muhammadahmedajaz/fobo-surface-robot/assets/build/pool-overview.jpg

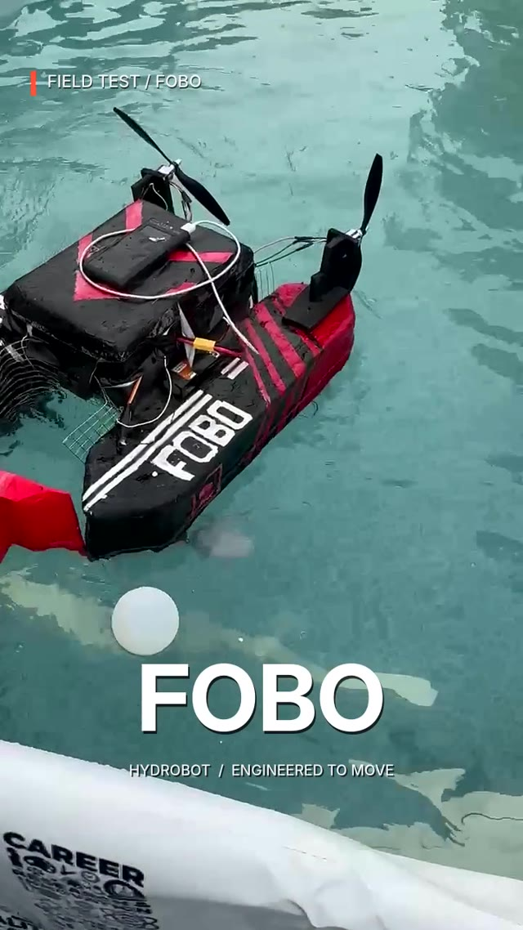
assets/build/pool-overview.jpg
