muhammadahmedajaz/fobo-surface-robot/assets/figures/control_architecture.png

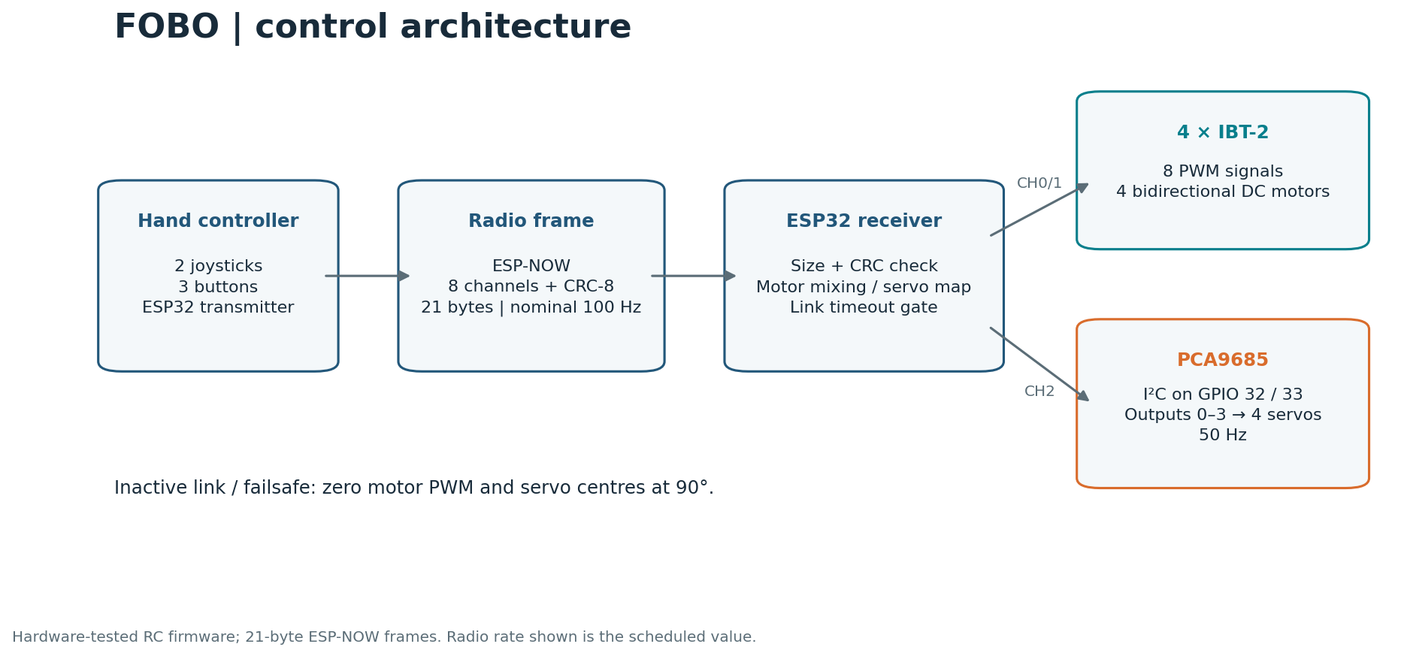
assets/figures/control_architecture.png
