muhammadahmedajaz/fobo-surface-robot/assets/figures/disturbance_rejection.png

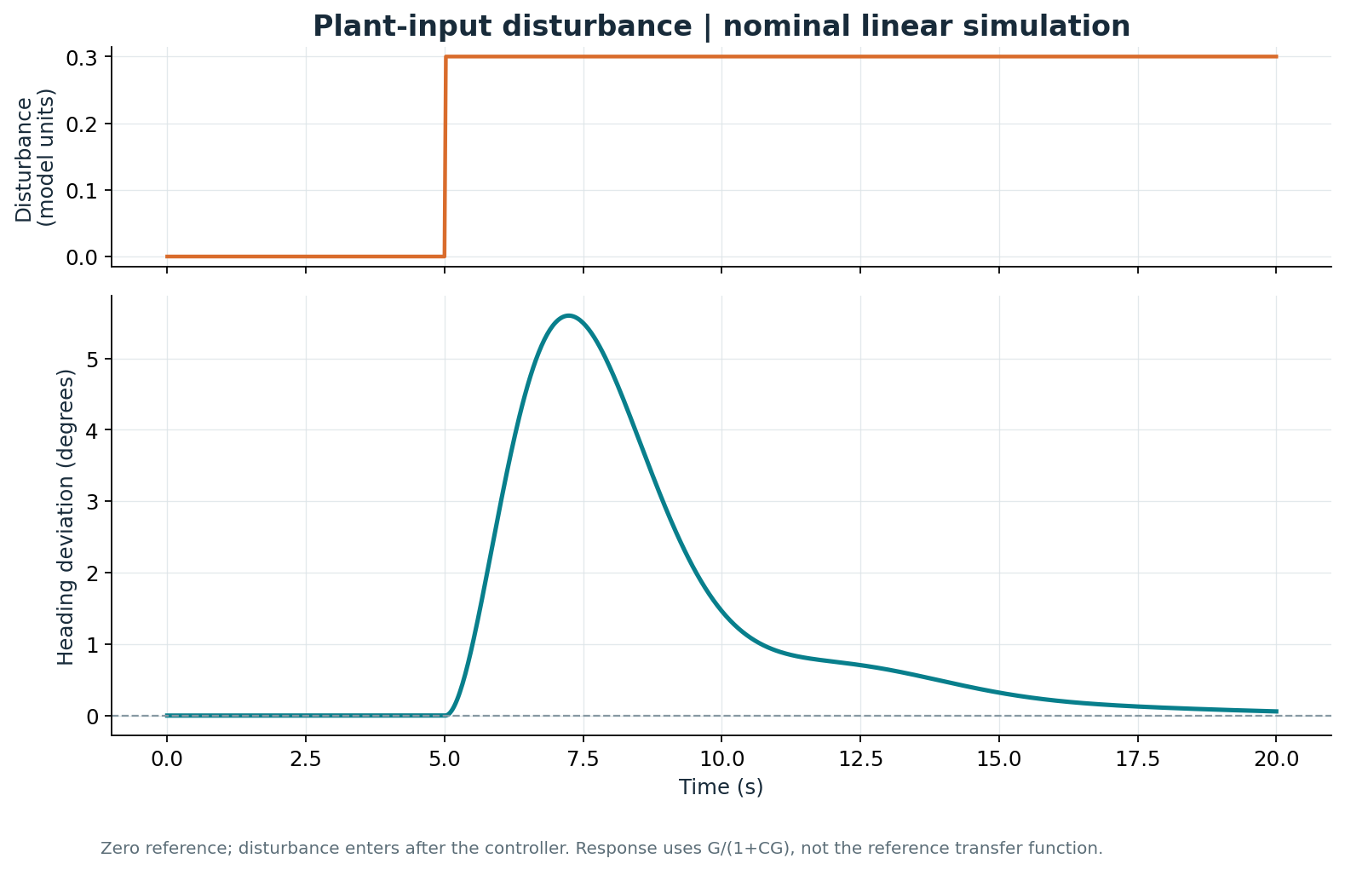
assets/figures/disturbance_rejection.png
