muhammadahmedajaz/fobo-surface-robot/assets/figures/motor_command_map.png

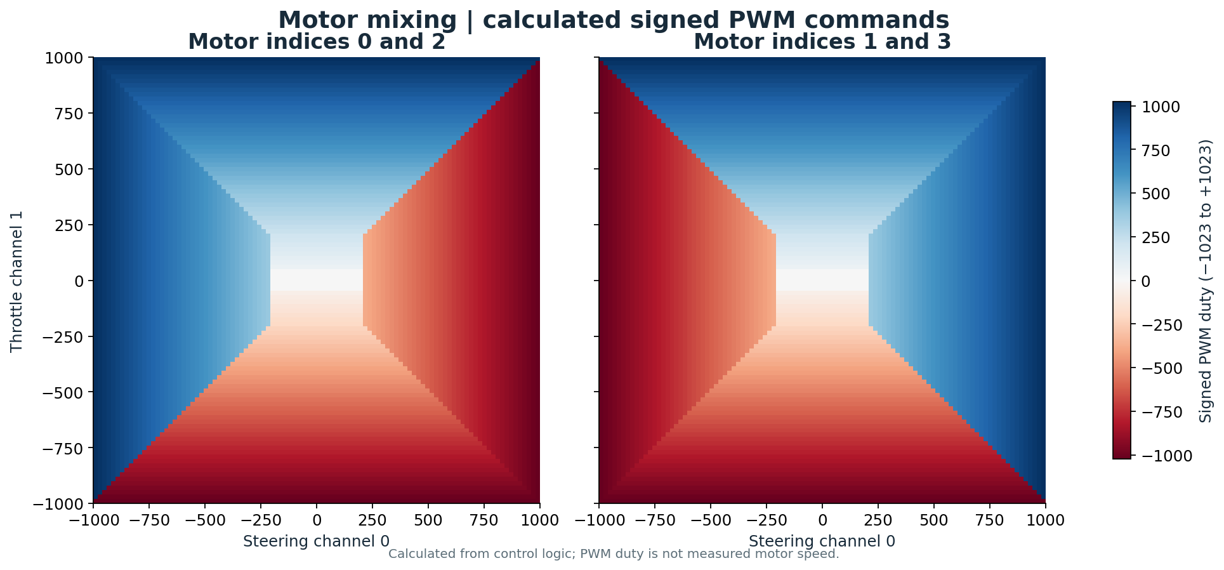
assets/figures/motor_command_map.png
