muhammadahmedajaz/fobo-surface-robot/assets/figures/servo_command_map.png

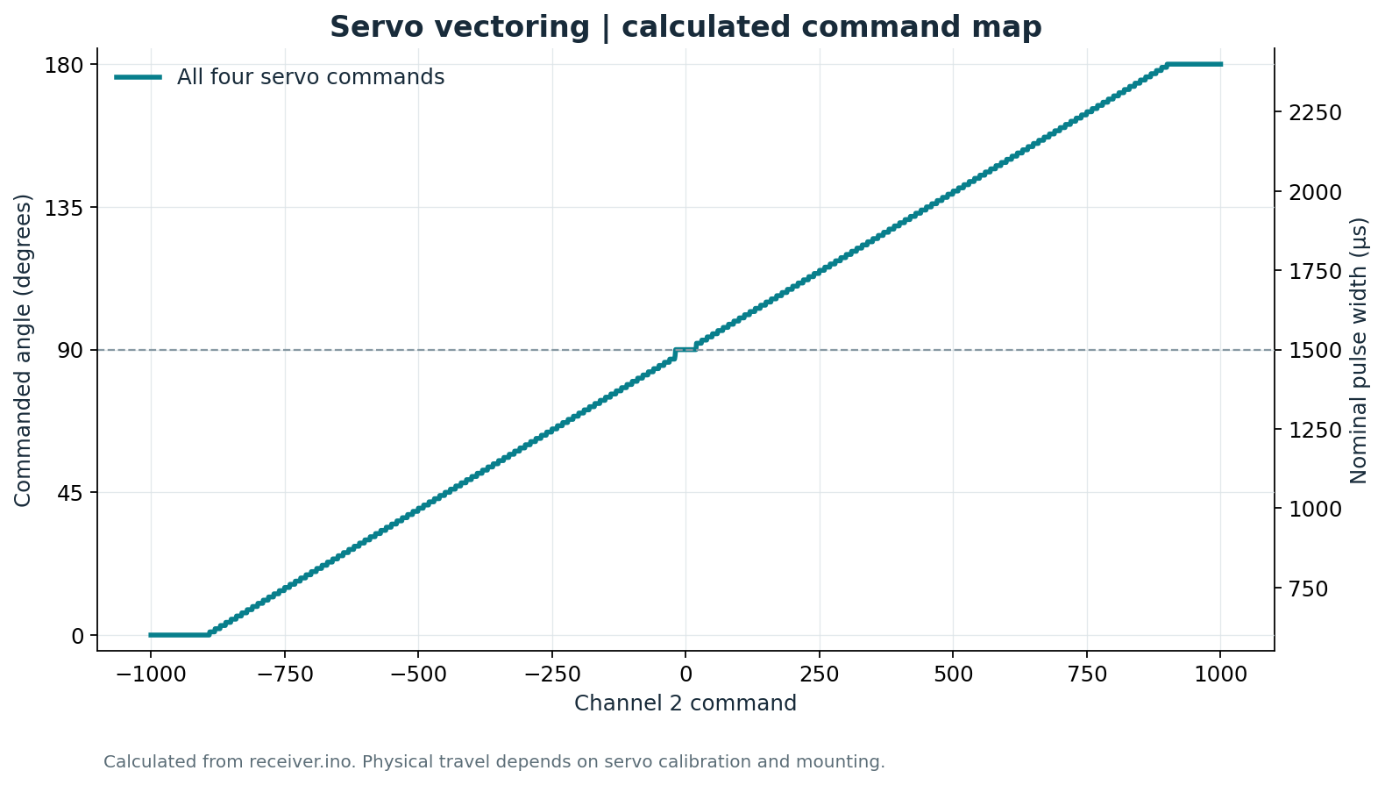
assets/figures/servo_command_map.png
