muhammadahmedajaz/fobo-surface-robot/assets/fobo-on-water.png

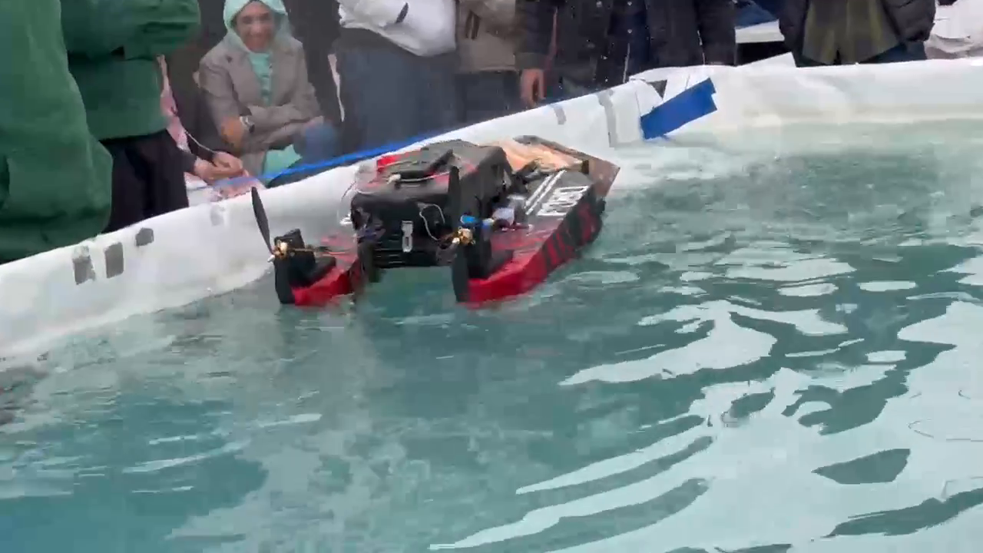
assets/fobo-on-water.png
