muhammadahmedajaz/fobo-surface-robot/assets/build/development/foam-shaping.jpg

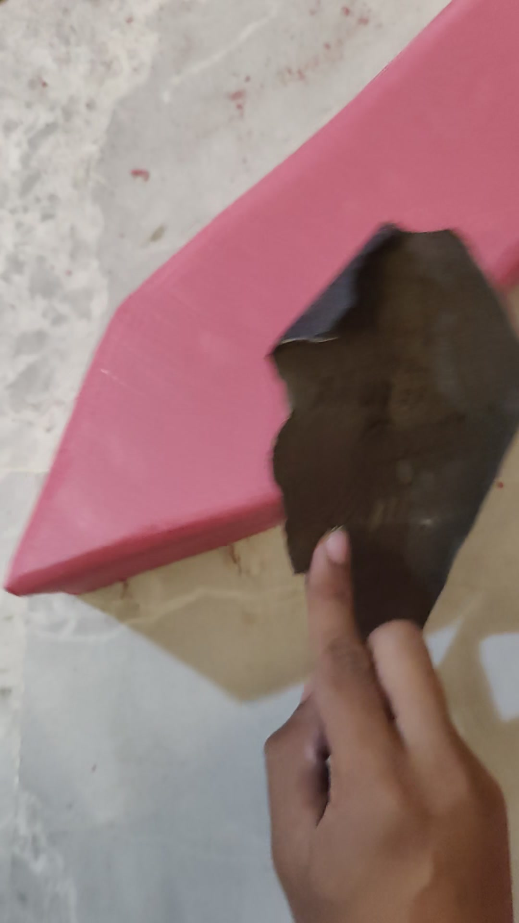
assets/build/development/foam-shaping.jpg
