muhammadahmedajaz/fobo-surface-robot/assets/build/development/hull-load-check.jpg

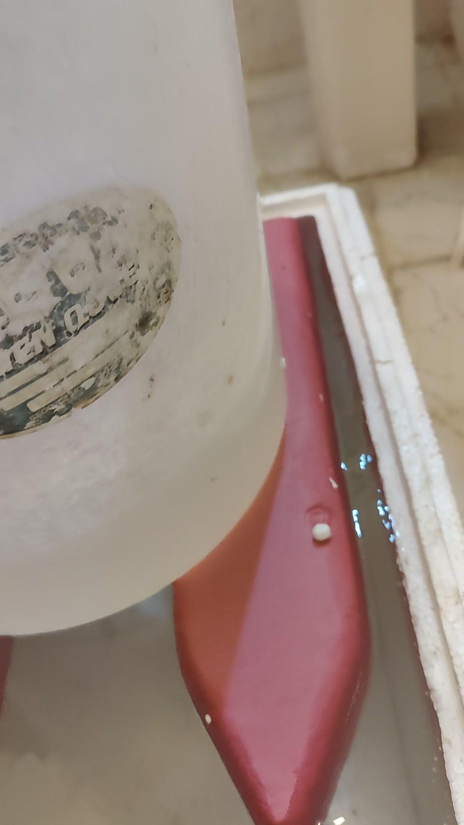
assets/build/development/hull-load-check.jpg
