muhammadahmedajaz/fobo-surface-robot/assets/build/development/open-water-run.jpg

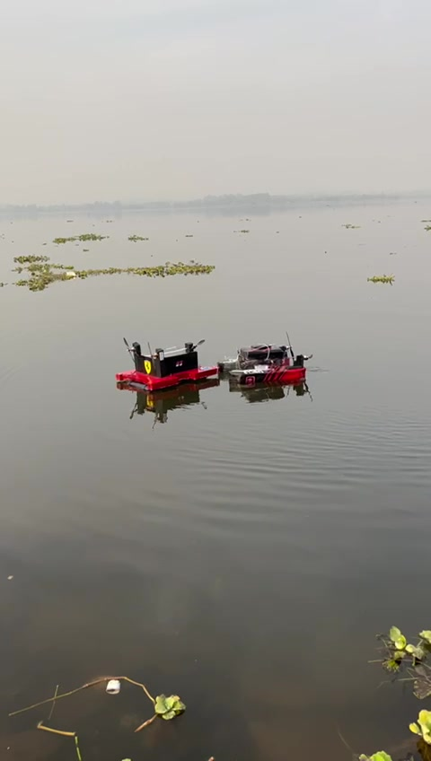
assets/build/development/open-water-run.jpg
