muhammadahmedajaz/fobo-surface-robot/assets/build/fiberglass-layup-1.jpg

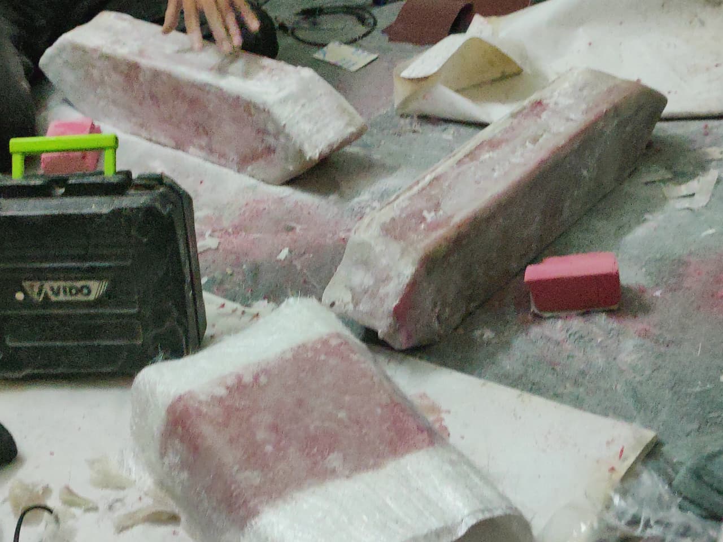
assets/build/fiberglass-layup-1.jpg
