muhammadahmedajaz/fobo-surface-robot/assets/build/fiberglass-layup-3.jpg

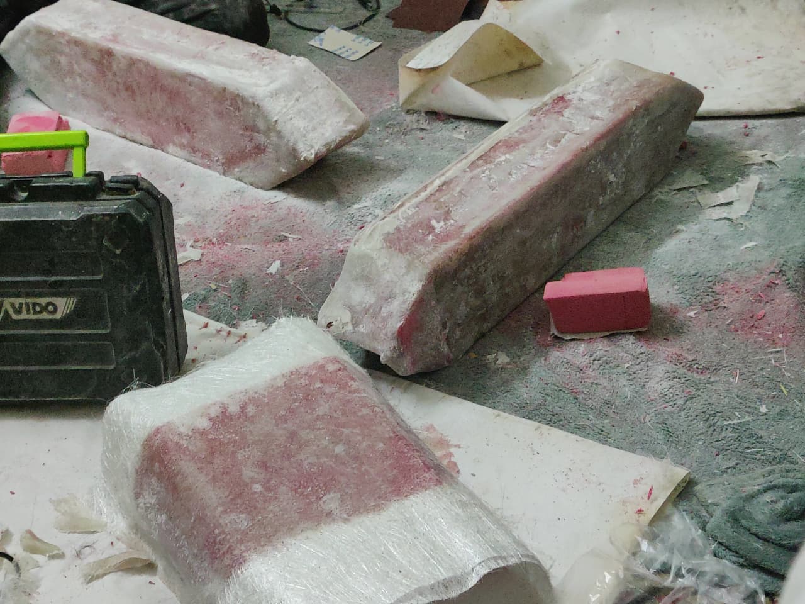
assets/build/fiberglass-layup-3.jpg
