muhammadahmedajaz/fobo-surface-robot/assets/build/outdoor-three-quarter.jpg

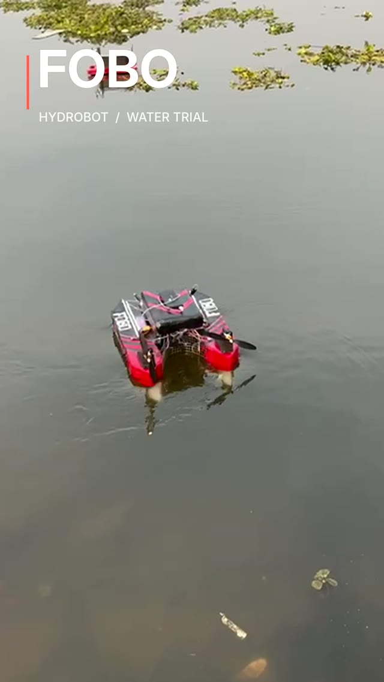
assets/build/outdoor-three-quarter.jpg
