muhammadahmedajaz/fobo-surface-robot/assets/build/outdoor-trial-closeup.jpg

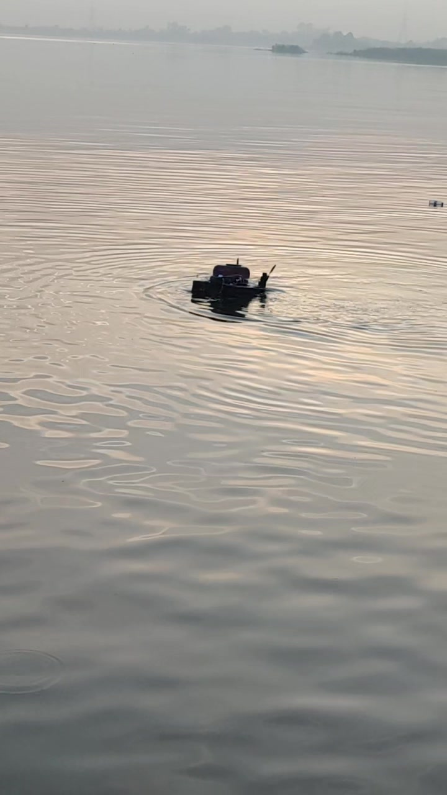
assets/build/outdoor-trial-closeup.jpg
