muhammadahmedajaz/fobo-surface-robot/assets/build/pool-ball-contact.jpg

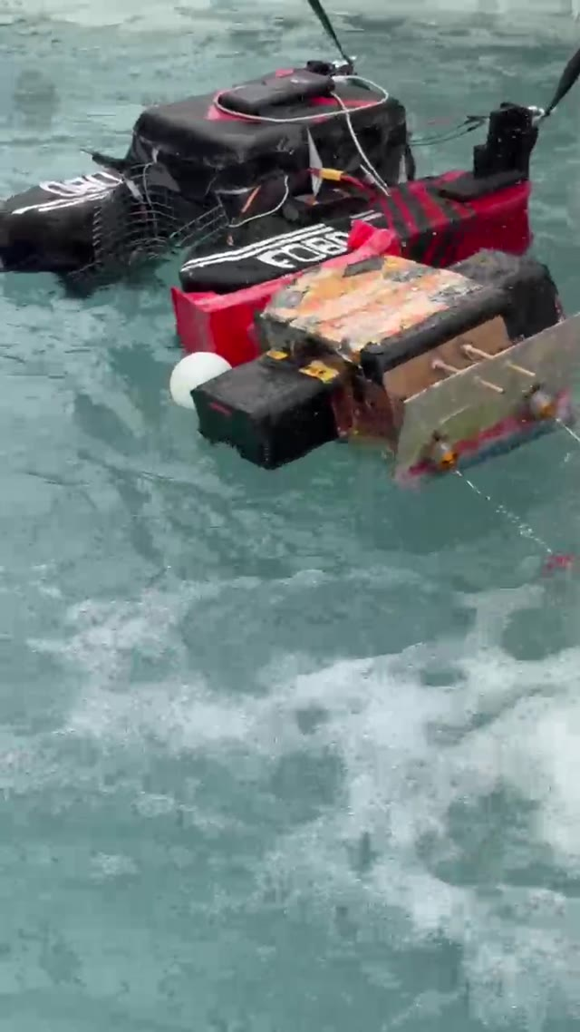
assets/build/pool-ball-contact.jpg
