muhammadahmedajaz/fobo-surface-robot/assets/build/pool-closeup.jpg

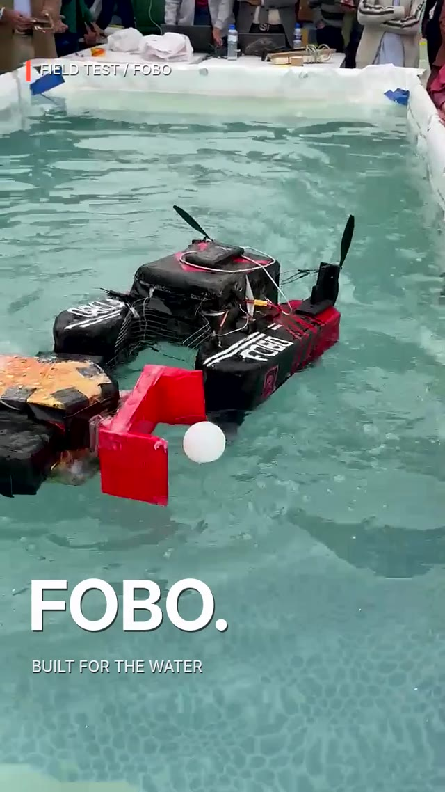
assets/build/pool-closeup.jpg
