muhammadahmedajaz/fobo-surface-robot/assets/build/xps-twin-hull-angle.png

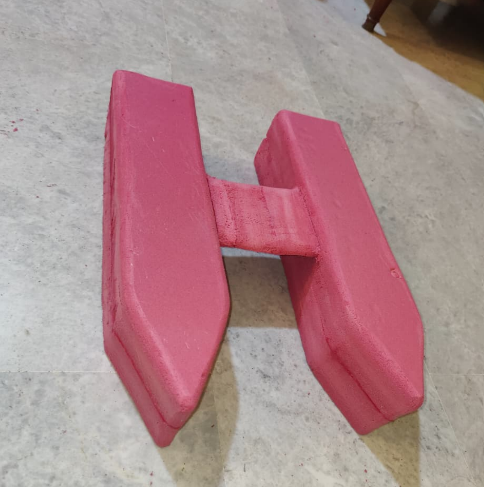
assets/build/xps-twin-hull-angle.png
