muhammadahmedajaz/fobo-surface-robot/assets/build/xps-twin-hull-top.png

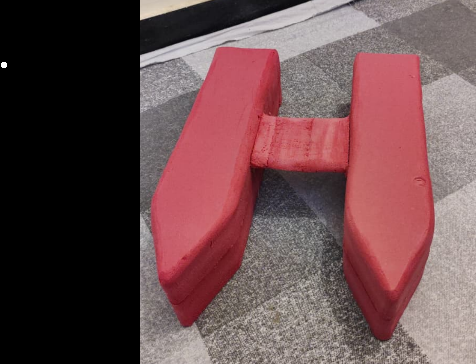
assets/build/xps-twin-hull-top.png
