muhammadahmedajaz/fobo-surface-robot/assets/figures/build-journey-timeline.png

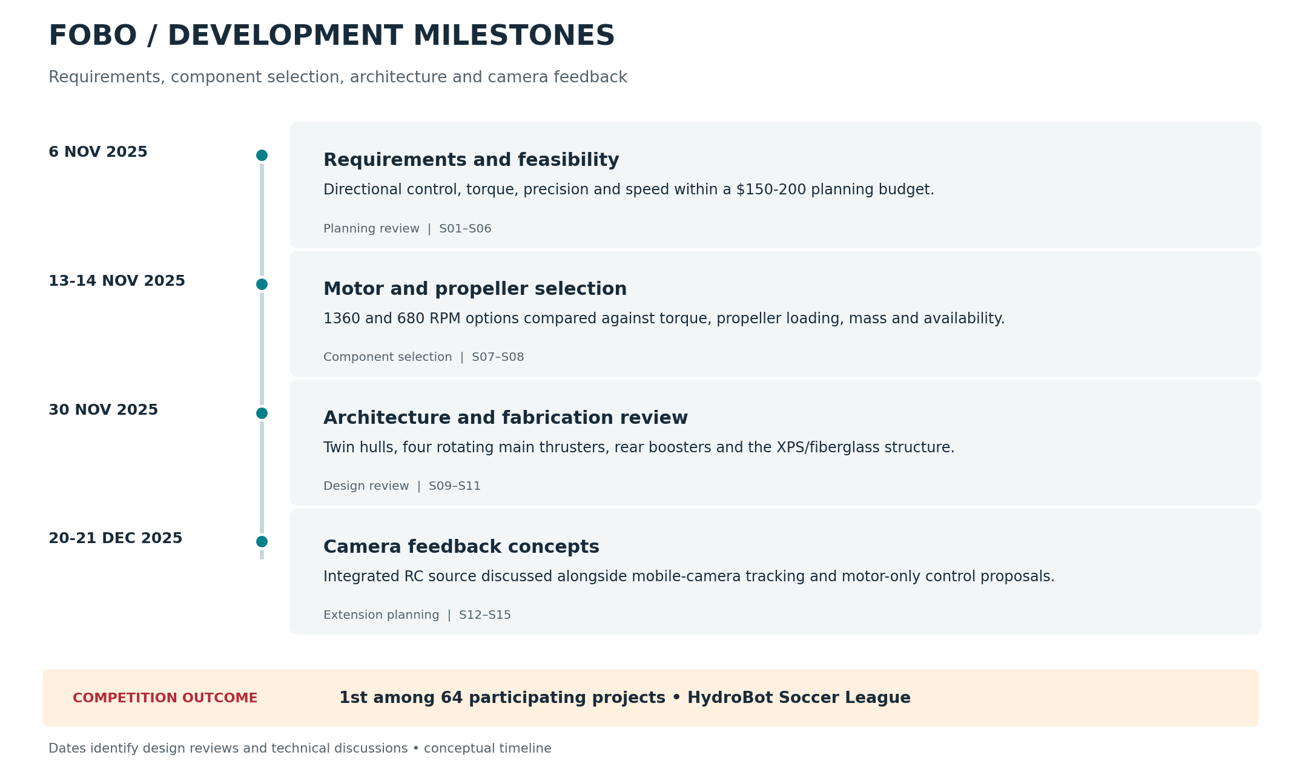
assets/figures/build-journey-timeline.png
