muhammadahmedajaz/fobo-surface-robot/CHANGELOG.md

# Changelog

## 2026-10-30

- Added eight development videos and stills covering manufacture, actuator integration and water trials.

- Reworked the README and engineering case study with project-focused technical language.
- Added a vector project cover.
- Reorganized the existing construction photographs and operating clips by build stage.
- Updated the gallery, design figures and technical reference notes.

- Added the engineering journey, eleven design decisions and technical reference index.
- Documented the early budget, hull/propulsion alternatives, motor/propeller questions, mass changes, complexity objections and later vision scope.
- Added reproducible development-timeline and hull-concept figures.
- Audited old assistant estimates and report claims so targets and suggestions remain distinct from built/tested results.

- Added the physical build story from design discussions, construction photographs and operating footage.
- Added foam/fiberglass construction photos, additional operating views, curated video excerpts and media provenance.
- Added component-layout, propulsion-mode and actuator-packaging diagrams, plus implementation notes.
- Recorded the confirmed XPS/hot-glue/silicone method, final-round servo ingress failure, four 680 RPM motors and approximate dimensions.
- Promoted the 1st-of-64 HydroBot result and documented the later mobile-camera/OpenCV work with its bench-tested scope.

- Published the hardware-tested ESP32 transmitter and integrated motor/PCA9685 receiver.
- Added a real project clip, controller architecture, receiver signal map and reference power-domain diagram.
- Added calculated servo/motor maps, nominal heading/disturbance plots, reproducible Python tools and CSV/JSON exports.
- Documented parts, exact pin assignments, packet format and reference build versions.
- Preserved the original MATLAB source and documented the disturbance-path correction in the analysis copy.
- Added protocol/model reference checks and a reference compilation workflow.

Firmware behaviour is preserved from the supplied hardware-tested baseline.
