muhammadahmedajaz/fobo-surface-robot/(commit log)

2026-10-29 Publish hardware-tested FOBO firmware and reproducible build resources
    [disturbance_rejection.csv, heading_step_response.csv, motor_command_map.csv, servo_command_map.csv]
2026-10-30 Document FOBO engineering journey and dated design decisions
    Reconstruct hull, propulsion, fabrication, sealing and control choices from dated discussions. Add eleven decision records, a source register, reproducible timeline and hull illustrations, and explicit handwriting/coverage gaps. Preserve the tested firmware.
2026-10-30 Refine FOBO cover and engineering case study
    Replace the lead image with a reproducible vector cover, revise the engineering case study and decision log, and organize the existing published gallery.
    Validated with seven analysis tests, 114 local link checks, figure regeneration and compilation of both ESP32 sketches.
    [generate_journey_figures.py, generate_mechanical_layout.py, generate_project_banner.py]
2026-10-30 Add FOBO development and water-trial recordings
    Publish eight complete development and operating recordings with still frames, source hashes and case-study links.
    Validation: 150 local links and anchors; all eight video hashes, durations, dimensions and encoding checks; seven analysis tests and both ESP32 compilation jobs passed.
